hoang1302/active-electrode-v2/Electrode_35x25_4x5_D2/Electrode_35x25_4x5_D2.pdf

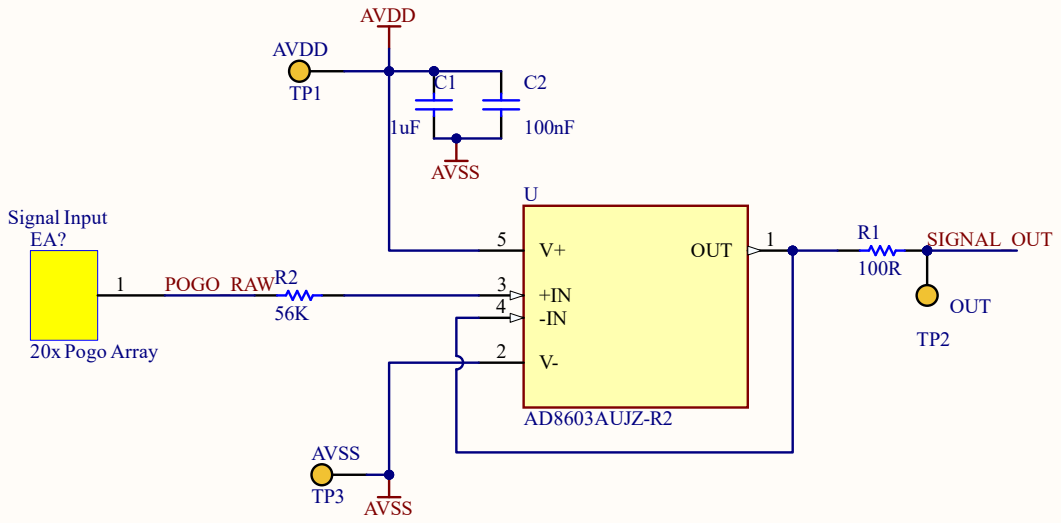
[picture p2: page 1]
Title; Size; Number; Revision; Date:; Sheet of; File:; C:\Users\..\01_Electrode.SchDoc; Drawn By:; OUT; AD8603AUJZ-R2; AVDD; AVSS; Signal Input; POGO_RAW; SIGNAL_OUT; 20x Pogo Array
