hoang1302/active-electrode-v2/(list of files, drawings)

Other design files:
Electrode_35x25_4x5_D2/Electrode_35x25_4x5_D2.PcbDoc
Electrode_35x25_4x5_D2/Electrode_35x25_4x5_D2.PcbLib
Electrode_35x25_4x5_D2/Electrode_35x25_4x5_D2.PrjPcb
Electrode_35x25_4x5_D2/Electrode_35x25_4x5_D2.SchDoc
Electrode_35x25_4x5_D2/Electrode_35x25_4x5_D2.SchLib
Electrode_35x25_4x5_D2_GUARD/Electrode_35x25_4x5_D2_GUARD.PcbDoc
Electrode_35x25_4x5_D2_GUARD/Electrode_35x25_4x5_D2_GUARD.PcbLib
Electrode_35x25_4x5_D2_GUARD/Electrode_35x25_4x5_D2_GUARD.PrjPcb
Electrode_35x25_4x5_D2_GUARD/Electrode_35x25_4x5_D2_GUARD.SchDoc
Electrode_35x25_4x5_D2_GUARD/Electrode_35x25_4x5_D2_GUARD.SchLib
Electrode_35x30_5x6_D2/Electrode_35x30_5x6_D2.PcbDoc
Electrode_35x30_5x6_D2/Electrode_35x30_5x6_D2.PcbLib
Electrode_35x30_5x6_D2/Electrode_35x30_5x6_D2.PrjPcb
Electrode_35x30_5x6_D2/Electrode_35x30_5x6_D2.SchDoc
Electrode_35x30_5x6_D2/Electrode_35x30_5x6_D2.SchLib
Electrode_35x30_5x6_D2p5/Electrode_35x30_5x6_D2p5.PcbDoc
Electrode_35x30_5x6_D2p5/Electrode_35x30_5x6_D2p5.PcbLib
Electrode_35x30_5x6_D2p5/Electrode_35x30_5x6_D2p5.PrjPcb
Electrode_35x30_5x6_D2p5/Electrode_35x30_5x6_D2p5.SchDoc
Electrode_35x30_5x6_D2p5/Electrode_35x30_5x6_D2p5.SchLib
Electrode_Flat_25x20/Electrode_Flat_25x20.PcbDoc
Electrode_Flat_25x20/Electrode_Flat_25x20.PcbLib
Electrode_Flat_25x20/Electrode_Flat_25x20.PrjPcb
Electrode_Flat_25x20/Electrode_Flat_25x20.SchDoc
Electrode_Flat_25x20/Electrode_Flat_25x20.SchLib
Panel_100x100_Slots.PcbDoc
